mpierdominici/power-quality-analyzer-/respuesta en frecuencia filtro aa/filtro de corriente.png

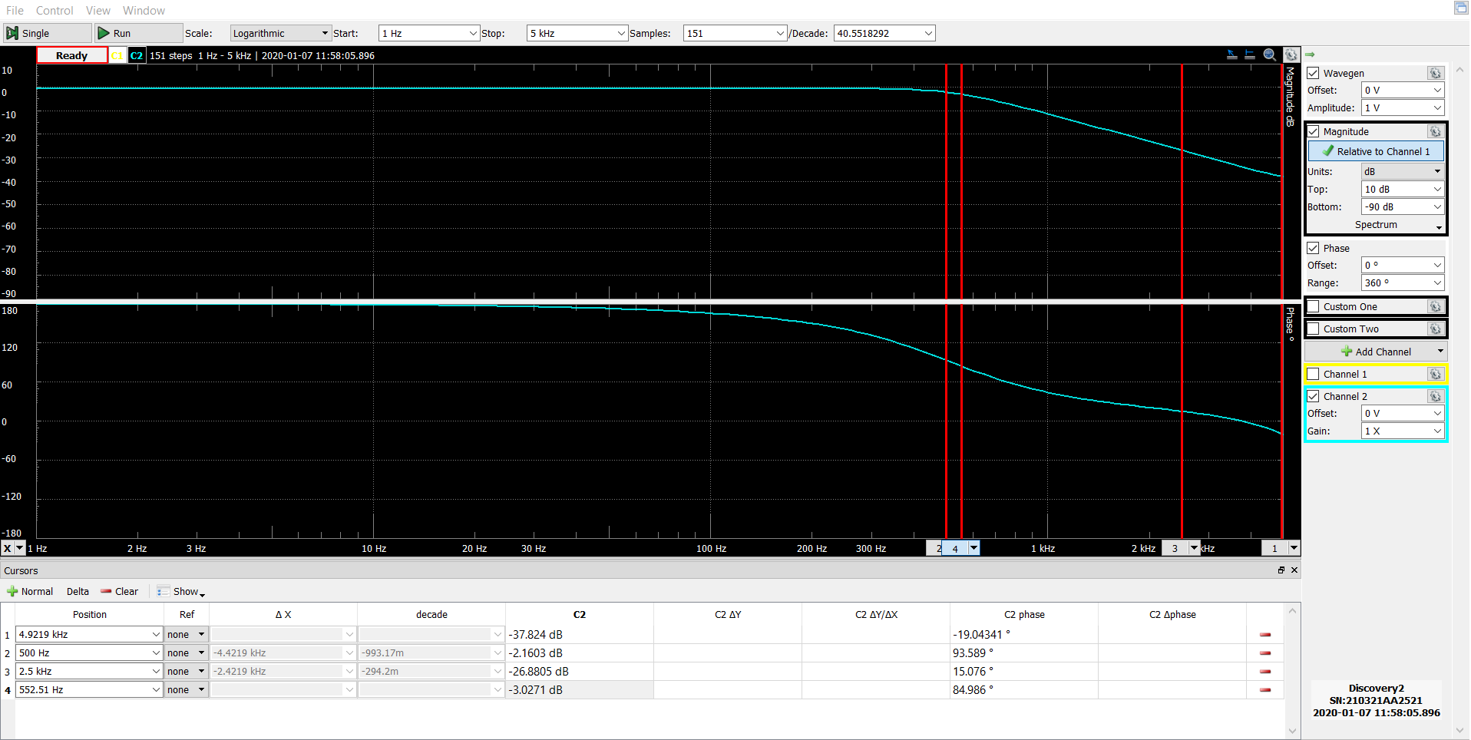
respuesta en frecuencia filtro aa/filtro de corriente.png
