mpierdominici/power-quality-analyzer-/respuesta en frecuencia filtro aa/filtro de tension.png

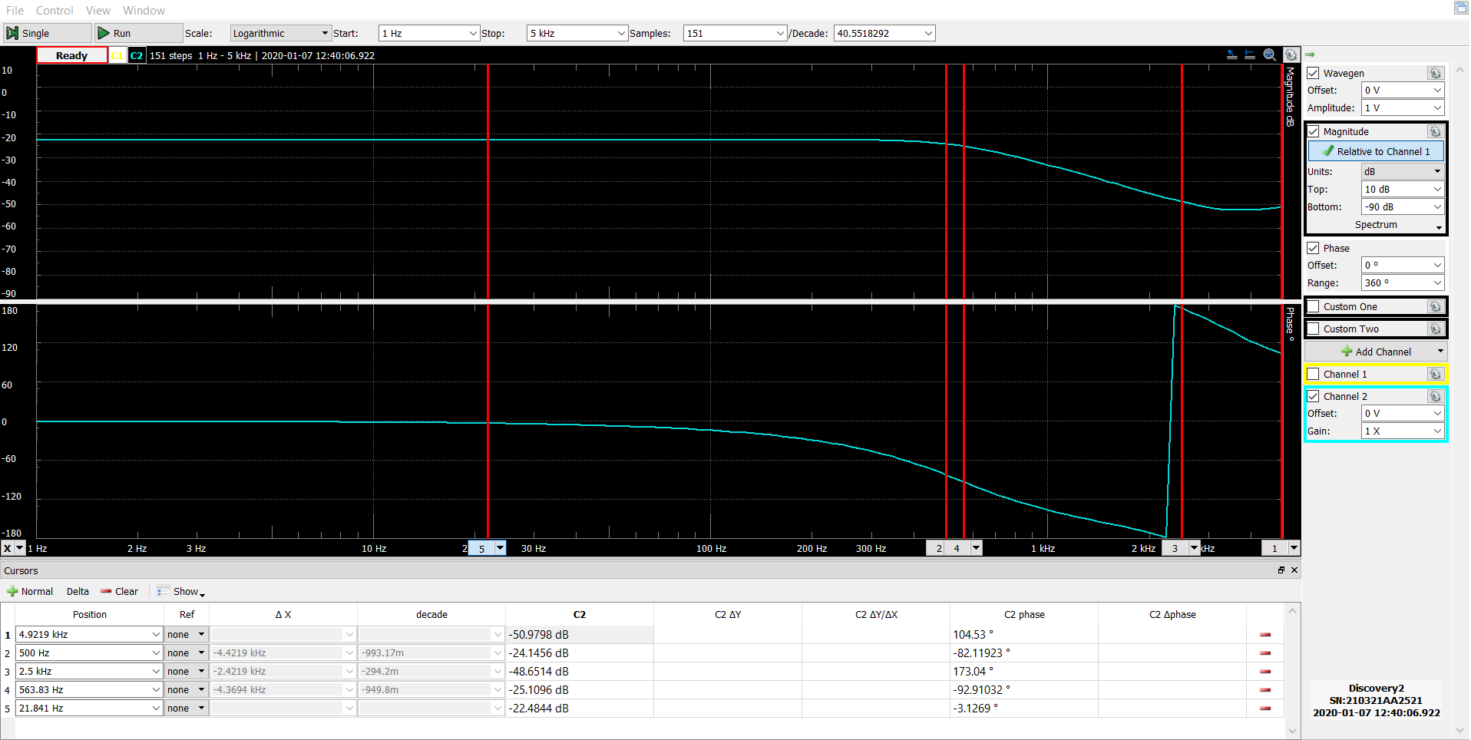
respuesta en frecuencia filtro aa/filtro de tension.png
