mpierdominici/power-quality-analyzer-/simulacion placa/sim.asc

C1: cap; 220n
C2: cap; 22n
C3: cap; 220n
C4: cap; 22n
R1: res; 1k2
R2: res; 18k
R5: res; 1k2
R6: res; 18k
U1: opamp2; TL084
U2: opamp2; TL084
V1: voltage; 2.8
V2: voltage; 5
V3: voltage; SINE(0 1 50)
V4: voltage; SINE(0 1 50)
Named nets: 0, 5v, 2.5v
.tran 0 1.1s 1 startup
.lib TL084.301
FILTRO AA - LP SALEN KEY - 500HZ
ADC0
SENSOR DE CORRIENTE
1 V AMP - 50 A
FILTRO AA - LP SALEN KEY - 500HZ
ADC1
SENSOR DE TENSION
