mpierdominici/power-quality-analyzer-/(list of files, drawings)

Other design files:
placa/adaptador y filtro/adaptador y filtro.PrjPcb
placa/adaptador y filtro/energyAnalizer.SchDoc
placa/adaptador y filtro/filter.SchDoc
placa/Imported TL084CN.lia/TL084CN.PcbLib
placa/Imported TL084CN.lia/TL084CN.SchLib
placa/shield mega/Arduino MEGA blank shield.pcbdoc
placa/shield mega/ArduinoMegaSheild.PrjPcb
placa/shield mega/Header.PcbLib
placa/shield mega/Header.SchLib
