mpierdominici/power-quality-analyzer-/(commit log)

2019-12-30 filtros y epiezo el codigo del sampleo de los dos canales
    [BOM.csv, Group Delay.csv, Input Impedance Magnitude.csv, Input Impedance Phase.csv, Magnitude(Volts per Volt).csv, Magnitude(dB).csv, Noise.csv, Phase Delay.csv]
2020-01-01 se hizo el pcb y fft de dos canales
    [Arduino MEGA blank shield.pcbdoc, ArduinoMegaSheild.PrjPcb, Header.PcbLib, Header.SchLib, adaptador y filtro.PrjPcb, energyAnalizer.SchDoc, filter.SchDoc]
2020-01-03 modifique la placa, solo filtro lp
    [Arduino MEGA blank shield.pcbdoc, TL084CN.PcbLib, TL084CN.SchLib]
2020-01-07 ya estoy midiendo potencia, y fp. tambien los armonicos
    [Arduino MEGA blank shield.pcbdoc, ArduinoMegaSheild.PrjPcb]
2020-01-08 progama de la arduino mega terminado
    [Arduino MEGA blank shield.CSV]
2020-01-08 ya anda el programa del nodemcu para comunicarse por mqtt
2020-01-10 programa instalado y funcionando. respecto al anterior se lo modifico para medir la thd de la tension y la corriente
